geonhee15/Cold-Gas-Thruster/checklist.txt

냉가스 리펄서 - 1단계 테스트 리그 부품 체크리스트
주문일: 2026-09-12

[공압 계통]
[ ] 아리타프로 컴프레서 AR-CMP10 (10L, 8bar, 오일리스)      162,000원
    - 도착하면 출력 포트에 레귤레이터+게이지 있는지 사진 확인
    - 벽 콘센트 직결 사용 (멀티탭 X)
[ ] 급속배기밸브 QEV - KCC정공 KQE201 (PT1/4)                24,600원 + 배송 3,000원
[ ] 솔레노이드 밸브 DC12V G1/4 DN8 NC 1.2MPa                 15,700원
    - NC(평시 닫힘) / 오리피스 8mm / G1/4 나사 - 테프론 처리
[ ] 원터치피팅 스트레이트 PC08-02                             1,200원 x 4개 + 배송 3,000원
    ** 수량 4개로 수정했는지 확인 **
[ ] 티피팅 PE8 (10개입)                                       8,090원
[ ] 우레탄 에어호스 8mm x 5mm, 10M                            8,830원
[ ] 황동 캡너트 1/4 (6.35mm)                                  1,100원 x 3개 + 배송 3,500원
    ** 수량 3개로 수정했는지 확인 ** -> 3/4/5mm 노즐 가공용

[전자 계통]
[ ] 로드셀 5kg + HX711 모듈 세트 (81mm 바 타입)              10,900원
    - 도착하면 HX711 보드 사진 찍어서 RATE 핀 개조 위치 확인
    - 나사 구멍 간격 실측 -> 마운트 3D모델에 반영
[ ] IRF520 MOSFET 모듈                                        5,000원
    - ESP32 3.3V 구동이라 발열/약한 개방 시 IRLZ44N으로 교체
[ ] 12V 2A 어댑터 (미소시스템 MSS-12V)                       11,260원
[ ] DC 터미널 젠더 5.5x2.1 2Pin (10개입)                      6,000원
[ ] 12mm 금속 푸시버튼 모멘터리 SPDT 12V (2개입)             11,490원
    - 암(데드맨) 스위치용
[ ] 드릴비트 7종 세트 3~8mm                                   7,340원
    - 캡너트 노즐 구멍 가공용 (3/4/5mm 사용)

[이미 보유]
[v] 보안경
[v] ESP32, 브레드보드, 점퍼선, 납땜 장비
[v] 3D프린터 + 필라멘트 (마운트는 PETG로, 노즐 주변 PLA 금지)

[합계] 약 280,000원 (컴프레서 162,000원 포함)

[도착 후 순서]
1. HX711 RATE 핀 3.3V 개조 (80Hz)
2. 로드셀 마운트 3D프린트 + 조립
3. 펌웨어 업로드 (repulsor_test_rig.ino) + 캘리브레이션 (c500)
4. 공압 라인 조립: 컴프레서 -> 호스 -> 솔레노이드(파일럿) + QEV -> 노즐
5. 3bar 저압 누설 체크 (비눗물)
6. 측정 매트릭스: 노즐 3/4/5mm x 압력 3/4/5bar x 펄스 100/200/500ms
   - 발사 전 계산기 예측값 노트에 먼저 기록
7. 실측 vs 계산 비교, Cd 실측값 도출

[안전 규칙]
- 노즐 전방 1m 비우기, 발사 중 보안경 착용
- 탱크 정격(8bar)의 70% = 5.6bar 이상 안 채움 (1단계)
- 암 스위치 데드맨 방식 유지, 배선 변경 시 밸브 전원 차단 후 작업
